HabitatMap/AirBeam2ElectronicSchematics/Airbeam 2.0 BOM.xlsx

Qty | Part Number | Description
1 | 1615RGBC | 1615RGBC
11 | CL10B104KA8NNNC | 0.1uf 25V 10% 0603 Capacitor
1 | VLS201610HBX-100M-1 | 10uH 650mA 786mOhm Inductor
1 | 12106D107MAT2A | 100uF Ceramic Capacitor 1210 20% 6.3V
8 | CRG0603F10K | 10K 0603 1% Resistor
3 | C1608C0G1H100C080AA | 10pF ±0.25pF 50V Ceramic Capacitor C0G, NP0 0603
2 | CL10A106MA8NRNC | 10uF 25V 20% 0603 Capacitor
1 | RC0603FR-07158KL | 158k Ohm Resistor 1/10W 0.5% 0603
1 | 403C35D16M00000 | 16MHz Crystal 3.2x2.5mm 4-SDM18pF 80ohm
1 | MMSZ5231BT1G | Zener Diode 5.1V 500mW 5% SOD-123
1 | RC0603JR-071KL | 1K OHM 5% 1/10W 0603 Resistor
10 | 1N914BWS | Diode Standard 75V 150mA SOD-323F
6 | CL10A105KO8NNNC | 1uf 16V 10% 0603 Capacitor
2 | RC0603JR-0722RL-S | 22 ohm Resistor 0603 1/10W 5%
1 | RC0603FR-072KL | 2K Resistor 0603 1/10W 1%
1 | 885012006005 | 33pF Ceramic Capacitor 0603 5% 10V
1 | RC0603JR-07470KL | 470K 0603 1/10W 5% Resistor
1 | 74VHCT125PW,118 | Buffer Non Inverting 4 Element 1 Bit per Element Push-Pull Output 14-TSSOP
1 | AP3012KTR-G1 | Boost Switching Regulator Adjustable 500mA
1 | ABBTM-NVC-MDCS42A | RF TXRX MOD BLUETOOTH TRACE ANT
1 | S2B-PH-SM4-TB(LF)(SN) | 2 Pin 2.0mm JST Right Angle Connector
1 | ESP8266 -12E | ESP8266 Wireless Module ESP-12
1 | 19-21/GHC-YR1S2/3T | LED GREEN CLEAR 0603 SMD
1 | MCP73831T-2ACI/OT | MCP73831T-AC Lipo Charger SOT23-5
1 | LC2259EENP | Switch Push DPDT
1 | SIM808 | SIM808
1 | C707 10M006 512 2 | Sim Card Holder
1 | SMF05CT2G | TVS Diode 5VWM 12.5VC SOT363
1 | SS1P3L-M3/84A | SS1P3L Schottky Diode 30V 1A
1 | MCP9700T-E/TT | MCP9700T Temperature Sensor SOT23-3
1 | U.FL-R-SMT-1(01) | Ultra Miniature Coaxial Connector Receptable
1 | HIH-5030-001 | Humidity Sensor
1 | 1054500101 | USB-C
2 | TS33H | Tactile Push Button
1 | AT90USB1286-MUR | AT90USB1286 (Teensy++)
1 | 20021321-00010C4LF | CONN RECEPT 10POS DUAL SMD
2 | F931C106MAA | 10uf Tantalum Capacitor 1206 16V 20%
1 | RC0603JR-07100KL | 100K Resistor 0603 1/10W 5%
3 | RC0603JR-07330RL | 330 ohm Resistor 0603 1/10W 5%
1 | TAJC337M006RNJ | 330uf Capacitor 2312 6.3V 20%
1 | MIC5209-3.3YS-TR | IC REG LINEAR 3.3V 500MA SOT223
