HabitatMap/AirBeam2ElectronicSchematics/Airbeam v2.4 12-21-2017.brd

## EAGLE design Airbeam v2.4 12-21-2017.brd (2018-02-19)

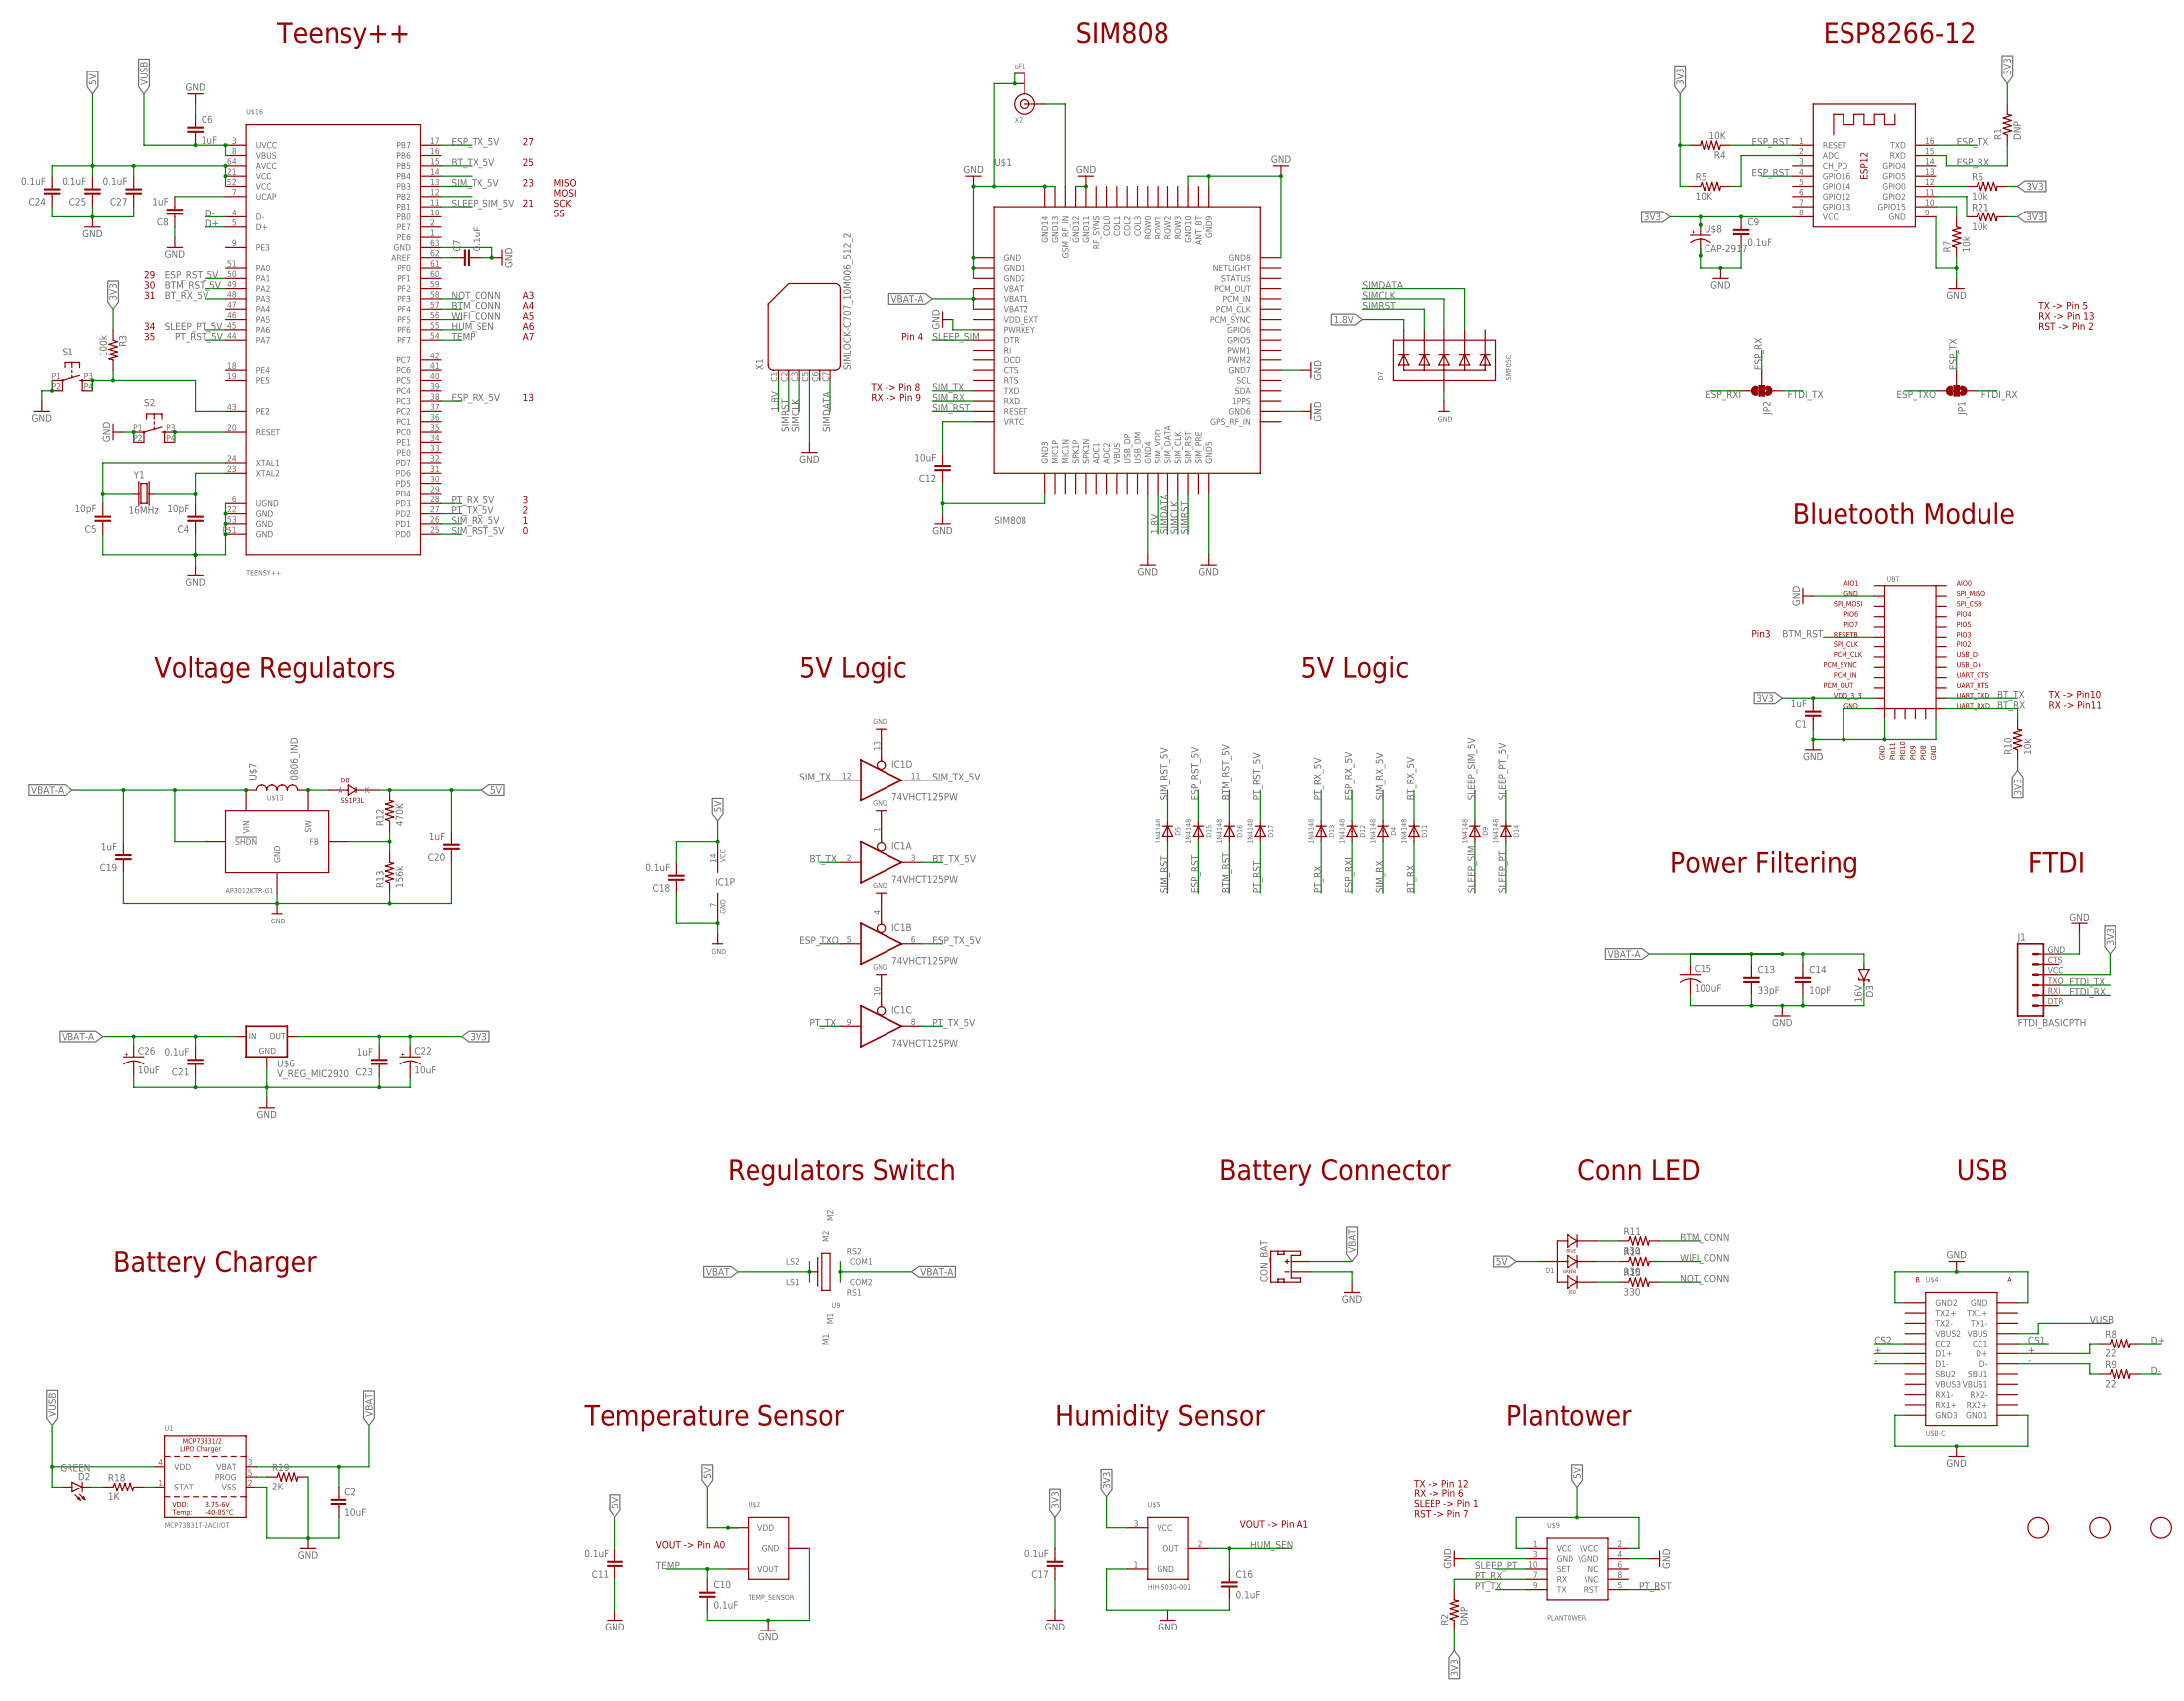
[picture p1: schematic Airbeam v2.4 12-21-2017.sch]

Parts:
C1, C6, C8, C19, C20, C23: 1uF; CAP0603
C2, C12: 10uF; CAP0603
C4, C5, C14: 10pF; CAP0603
C7, C9, C10, C11, C16, C17, C18, C21, C24, C25, C27: 0.1uF; CAP0603
C13: 33pF; CAP0603
C15: 100uF; C1210
C22, C26: 10uF; EIA3216
CON_BAT: CON_BAT; JST-2-SMD; PARTNO S2B-PH-SM4-TB(LF)(SN)
D1: LED1615RGBC
D2: GREEN; LED-0603
D3: 16V; SOD-123
D4, D5, D9, D11, D12, D13, D14, D15, D16, D17: 1N4148; SOD-323
D7: SMF05C; SOT363
D8: SS1P3L; DO220AAL
IC1: 74VHCT125PW; TSSOP14
J1: FTDI_BASICPTH; FTDI_BASIC
JP1, JP2: JUMPER-PAD-3-2OF3_NC_BY_TRACE_SMALL; PAD-JUMPER-3-2OF3_NC_BY_TRACE_YES_SILK_FULL_BOX
R1, R2: DNP; RES-0603
R3: 100k; RES-0603
R4, R5: 10K; RES-0603
R6, R7, R10, R21: 10k; RES-0603
R8, R9: 22; RES-0603
R11, R14, R15: 330; RES-0603
R12: 470K; RES-0603
R13: 156k; RES-0603
R18: 1K; RES-0603
R19: 2K; RES-0603
S1, S2: JAYCONSYSTEMS_TAC_SWITCHHIRO; JAYCONSYSTEMS_TS-1184
U1: MCP73831T-2ACI/OT; SOT23-5
U9: PUSHBUTTON
U$1: SIM808
U$2: TEMP_SENSOR; SOT23-3
U$3, U$12, U$14: FIDUCIAL; FIDUCIAL_1MM
U$4: USB-C
U$5: HIH-5030-001; HUM_SEN
U$6: V_REG_MIC2920; SOT223
U$7: 0806_IND; 0806
U$8: CAP-2917; EIA2917
U$9: PLANTOWER; CONN
U$13: AP3012KTR-G1; SOT23-5
U$16: TEENSY++; 64QFN
UBT: BT-NVC-MDCS42A; BT_NVC-MDCS42A
X1: SIMLOCK-C707_10M006_512_2; C707_10M006_512_2
X2: uFL; U.FL
X3: ESP-12
Y1: 16MHz; CRYSTAL-3.2X2.5

Connections:
1.8V: D7.1 (C1), U$1.29 (SIM_VDD), X1.C1 (1)
3V3: C1.2, C9.1, C17.2, C22.A (+), C23.2, J1.VCC (4), R1.2, R2.1, R3.1, R4.2, R5.1, R6.2, R10.1, R21.2, U$5.3 (VCC), U$6.3 (OUT), U$8.1 (+), UBT.P$12, X3.8 (VCC)
5V: C11.2, C18.2, C20.2, C24.2, C25.2, C27.2, D1.1 (ANODE), D8.P$1 (K), IC1.14 (VCC), R12.2, U$2.1 (VDD), U$9.1 (VCC), U$9.2 (\VCC), U$16.21 (VCC), U$16.52 (VCC), U$16.64 (AVCC)
+: R8.1, U$4.A6 (D+), U$4.B6 (D1+)
-: R9.1, U$4.A7 (D-), U$4.B7 (D1-)
BTM_CONN: R11.2, U$16.57 (PF4)
BTM_RST: D16.A, UBT.P$6
BTM_RST_5V: D16.C, U$16.49 (PA2)
BT_RX: D11.A, R10.2, UBT.P$20
BT_RX_5V: D11.C, U$16.48 (PA3)
BT_TX: IC1.2 (I), UBT.P$21
BT_TX_5V: IC1.3 (O), U$16.15 (PB5)
CS1: U$4.A5 (CC1)
CS2: U$4.B5 (CC2)
D+: R8.2, U$16.5 (D+)
D-: R9.2, U$16.4 (D-)
ESP_RST: D15.A, R4.1, X3.1 (RESET), X3.4 (GPIO16)
ESP_RST_5V: D15.C, U$16.50 (PA1)
ESP_RX: JP2.2, R1.1, X3.15 (RXD)
ESP_RXI: D12.A, JP2.3
ESP_RX_5V: D12.C, U$16.38 (PC3)
ESP_TX: JP1.2, X3.16 (TXD)
ESP_TXO: IC1.5 (I), JP1.3
ESP_TX_5V: IC1.6 (O), U$16.17 (PB7)
FTDI_RX: J1.RXI (2), JP1.1
FTDI_TX: J1.TXO (3), JP2.1
GND: C1.1, C2.2, C4.1, C5.1, C6.1, C7.2, C8.1, C9.2, C10.2, C11.1, C12.1, C13.2, C14.2, C15.2, C16.2, C17.1, C18.1, C19.1, C20.1, C21.1, C22.C (-), C23.1, C24.1, C25.1, C26.C (-), C27.1, CON_BAT.1 (-), D3.C, D7.2 (A), IC1.1 (OE), IC1.4 (OE), IC1.7 (GND), IC1.10 (OE), IC1.13 (OE), J1.GND (6), R7.1, R13.1, R19.2, S1.P1 (1), S1.P2 (2), S2.P1 (1), S2.P2 (2), U1.2 (VSS), U$1.1 (GND), U$1.2 (GND1), U$1.3 (GND2), U$1.8 (PWRKEY), U$1.18 (GND3), U$1.28 (GND4), U$1.34 (GND5), U$1.36 (GND6), U$1.40 (GND7), U$1.51 (GND8), U$1.52 (GND9), U$1.54 (GND10), U$1.64 (GND11), U$1.65 (GND12), U$1.67 (GND13), U$1.68 (GND14), U$2.3 (GND), U$4.A1 (GND), U$4.A12 (GND1), U$4.B1 (GND2), U$4.B12 (GND3), U$5.1 (GND), U$6.2 (GND), U$6.4 (GND), U$8.2 (-), U$9.3 (GND), U$9.4 (\GND), U$13.2 (GND), U$16.6 (UGND), U$16.22 (GND), U$16.53 (GND), U$16.63 (GND), U$16.P$1 (GND), UBT.P$2, UBT.P$13, UBT.P$14, UBT.P$19, X1.C5 (4), X2.1 (GND), X2.2 (GND), X3.9 (GND)
HUM_SEN: C16.1, U$5.2 (OUT), U$16.55 (PF6)
unnamed: R5.2, X3.2 (ADC)
unnamed: S2.P3 (3), S2.P4 (4), U$16.20 (RESET)
unnamed: C8.2, U$16.7 (UCAP)
unnamed: C7.1, U$16.62 (AREF)
unnamed: D2.C, R18.1
unnamed: R21.1, X3.11 (GPIO2)
unnamed: R18.2, U1.1 (STAT)
unnamed: R3.2, S1.P3 (3), S1.P4 (4), U$16.43 (PE2)
unnamed: R7.2, X3.10 (GPIO15)
unnamed: D1.4 (BLUE_CATHODE), R11.1
unnamed: U$1.66 (GSM_RF_IN), X2.3 (SIGNAL)
unnamed: C12.2, U$1.17 (VRTC)
unnamed: D1.3 (GREEN_CATHODE), R14.1
unnamed: R12.1, R13.2, U$13.3 (FB)
unnamed: R19.1, U1.5 (PROG)
unnamed: R6.1, X3.12 (GPIO0)
unnamed: D1.2 (RED_CATHODE), R15.1
unnamed: D8.P$2 (A), U$7.2, U$13.1 (SW)
unnamed: C5.2, U$16.24 (XTAL1), Y1.1
unnamed: C4.2, U$16.23 (XTAL2), Y1.3 (2)
NOT_CONN: R15.2, U$16.58 (PF3)
PT_RST: D17.A, U$9.5 (RST)
PT_RST_5V: D17.C, U$16.44 (PA7)
PT_RX: D13.A, R2.2, U$9.7 (RX)
PT_RX_5V: D13.C, U$16.28 (PD3)
PT_TX: IC1.9 (I), U$9.9 (TX)
PT_TX_5V: IC1.8 (O), U$16.27 (PD2)
SIMCLK: D7.4 (C3), U$1.31 (SIM_CLK), X1.C3 (3)
SIMDATA: D7.5 (C4), U$1.30 (SIM_DATA), X1.C7 (6)
SIMRST: D7.3 (C2), U$1.32 (SIM_RST), X1.C2 (2)
SIM_RST: D5.A, U$1.16 (RESET)
SIM_RST_5V: D5.C, U$16.25 (PD0)
SIM_RX: D4.A, U$1.15 (RXD)
SIM_RX_5V: D4.C, U$16.26 (PD1)
SIM_TX: IC1.12 (I), U$1.14 (TXD)
SIM_TX_5V: IC1.11 (O), U$16.13 (PB3)
SLEEP_PT: D14.A, U$9.10 (SET)
SLEEP_PT_5V: D14.C, U$16.45 (PA6)
SLEEP_SIM: D9.A, U$1.9 (DTR)
SLEEP_SIM_5V: D9.C, U$16.11 (PB1)
TEMP: C10.1, U$2.2 (VOUT), U$16.54 (PF7)
VBAT: C2.1, CON_BAT.2 (+), U1.3 (VBAT), U9.LS1, U9.LS2
VBAT-A: C13.1, C14.1, C15.1, C19.2, C21.2, C26.A (+), D3.A, U9.C1 (COM1), U9.C2 (COM2), U$1.4 (VBAT), U$1.5 (VBAT1), U$1.6 (VBAT2), U$6.1 (IN), U$7.1, U$13.4 (!SHDN), U$13.5 (VIN)
VUSB: C6.2, D2.A, U1.4 (VDD), U$4.A4 (VBUS), U$16.3 (UVCC), U$16.8 (VBUS)
WIFI_CONN: R14.2, U$16.56 (PF5)

Notes on the sheet:
Teensy++
SIM808
ESP8266-12
Voltage Regulators
Bluetooth Module
USB
Power Filtering
Battery Charger
Battery Connector
5V Logic
Plantower
Regulators Switch
Humidity Sensor
Temperature Sensor
RX -> Pin11
TX -> Pin10
RX -> Pin 9
TX -> Pin 8
RX -> Pin 13
TX -> Pin 5
RX -> Pin 6
TX -> Pin 12
VOUT -> Pin A0
VOUT -> Pin A1
Pin 4
RST -> Pin 2
Pin3
SLEEP -> Pin 1
RST -> Pin 7
Conn LED
FTDI
SCK
MOSI
MISO

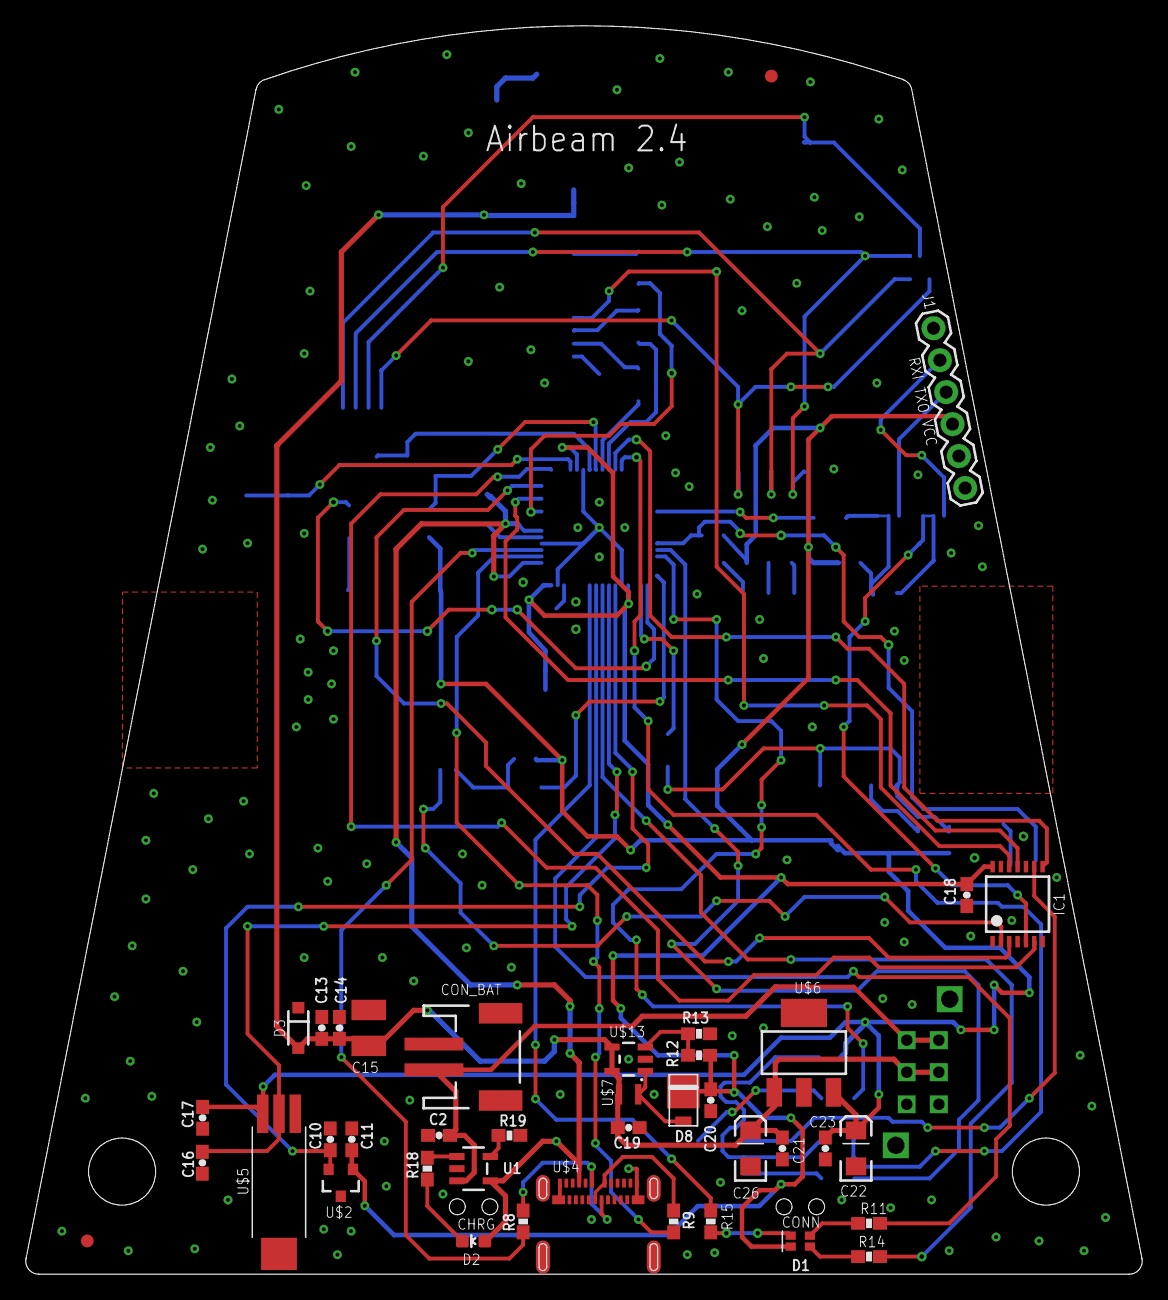
[picture p2: board Airbeam v2.4 12-21-2017.brd from above]

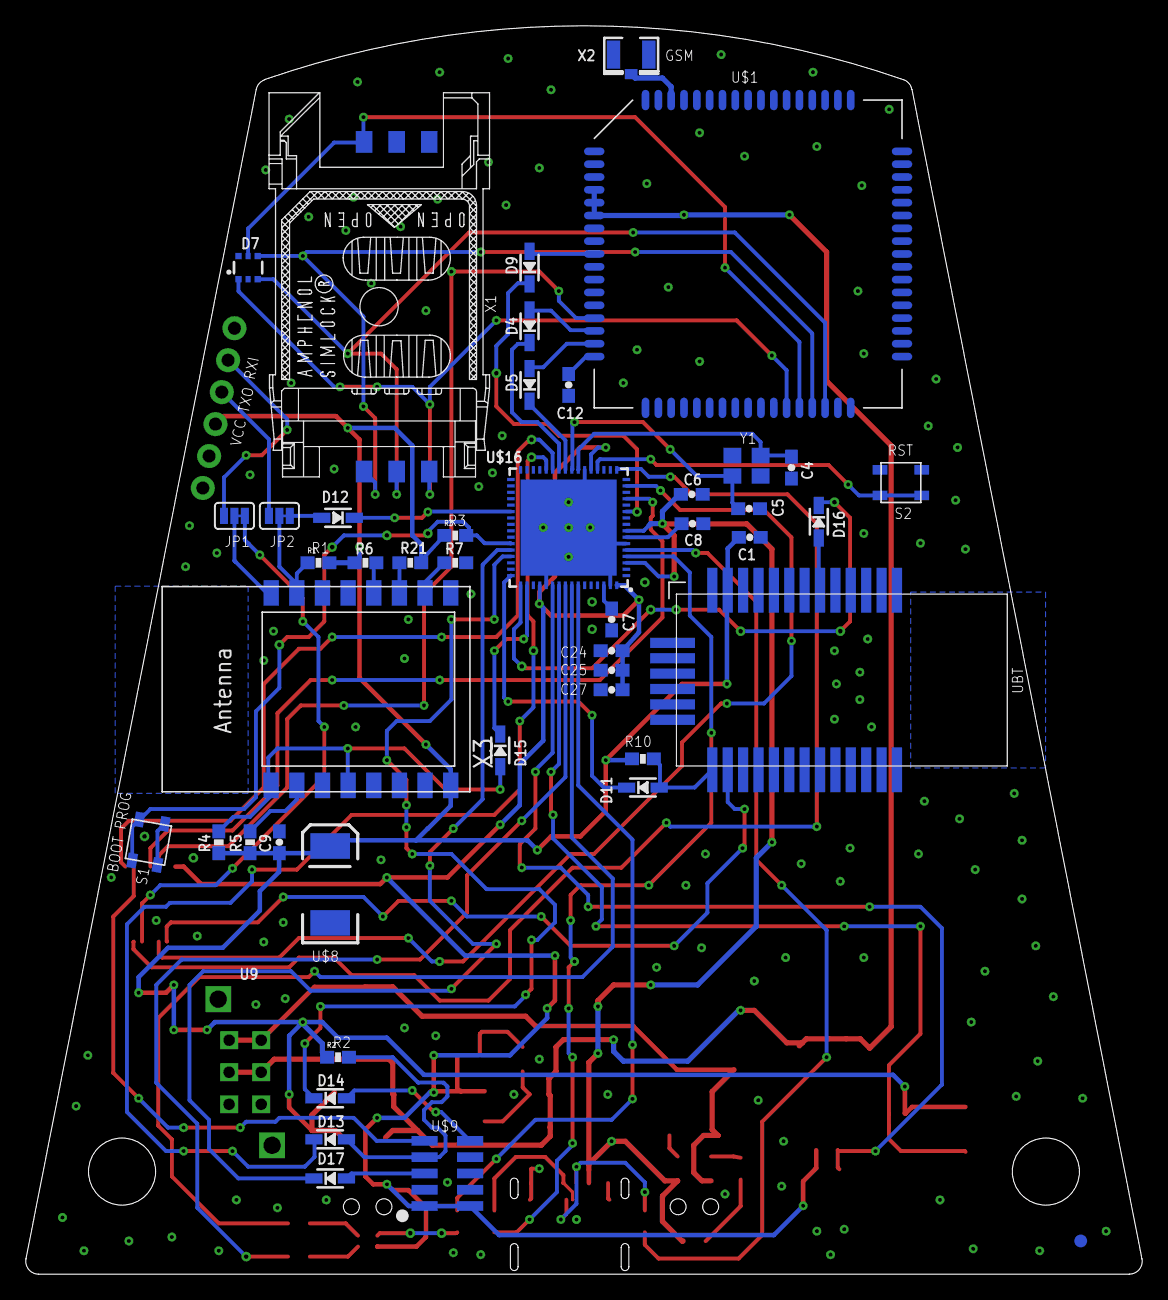
[picture p3: board Airbeam v2.4 12-21-2017.brd from below]

Board: 2 copper layers, 87.0 x 97.3 mm, 86 parts (46 on the bottom side), 71 nets.
